Vasilis-Narain/Kibble/HARDWARE_SELECTION.md

## Hardware requirements

Target: 320x240, 16 bit colour, 60 fps. Mainly 2D games, possibly DOOM style 3D games.
Games are copied onto an SD card and loaded into internal SRAM at runtime.

### Overview
- MCU: STM32H7A3ZIT6Q (280MHz, 2MB flash, ~1.4MB sram, LQFP144)
- Display: [NHD-2.8-240320AF-CSXP-F](https://www.digikey.it/en/products/detail/newhaven-display-intl/NHD-2-8-240320AF-CSXP-F/9849907) (2.8" 240x320 IPS, ST7789Vi, 16-bit parallel 8080, TE pin)
- Audio: MAX98357AETE+T (I2S DAC + class-D amp) + 8 ohm 1W speaker
- Storage: microSD over SDMMC 4-bit
- Controls: 4 face + 4 D-pad + 2 shoulder + 2 menu + power button, hall effect joystick
- Power: 1S LiPo, USB-C charging, 3.3V for everything
- 1 green power LED

### MCU
- STM32H7A3 has 1MB of contiguous AXI sram - fits both framebuffers and a whole game, no external RAM needed
  - STM32H743 is faster (480MHz) but its RAM is split (largest block 512KB AXI) and it has no SMPS
- LQFP144 - exposes FMC pins, routes on 4 layers (BGA would need finer vias), JLCPCB-assembled
  - LCSC C730224 - check it's the -Q variant and in stock before ordering
- Q variant (internal SMPS) - same pinout as the NUCLEO-H7A3ZI-Q
  - 97 GPIOs in LQFP144 (non-Q: 112) - enough for the ~57 needed
  - SMPS roughly halves MCU current @280MHz (~34mA vs ~70mA with LDO, DS13195 table 37)
  - SMPS is optional - without its inductor + caps the chip runs from the internal LDO
- Double buffered framebuffer (2x 150KB) in internal AXI sram
- Game code + assets in the remaining ~700KB of AXI sram
- 8MHz HSE crystal - accurate clocks for USB and audio
- Decoupling + VCAP capacitors - follow the datasheet reference design

### Display
- [NHD-2.8-240320AF-CSXP-F](https://www.digikey.it/en/products/detail/newhaven-display-intl/NHD-2-8-240320AF-CSXP-F/9849907) ([datasheet](https://newhavendisplay.com/content/specs/NHD-2.8-240320AF-CSXP-F.pdf))
  - Bare panel, ST7789Vi controller built into the glass - no controller on the PCB
  - 40-pin 0.5mm FFC: Molex 54132-4062 socket on the PCB (LCSC C505102), JLCPCB-assembled
    - Bottom contact - FFC contacts must face the PCB, check against the panel's cable drawing
  - IM0, IM1, IM2 to GND = 16-bit 8080-II, DB0-DB15
  - VDD + VDDI to 3.3V
  - Panel is natively portrait (240x320) - rotate to landscape with MADCTL
- 16-bit parallel via FMC + DMA
  - 60 fps needs ~9.2MB/s (320 x 240 x 2 bytes x 60) - SPI can't reach this, parallel can
- TE pin to GPIO - start frame transfers on it to avoid tearing
- RESET pin to GPIO
- Backlight: bare LEDs (LED-A, LED-K1-K4), 3.1V, max 160mA
  - Needs a PWM-dimmable constant current driver
  - [ ] Pick backlight driver - 3.3V rail has too little headroom for 3.1V LEDs
- Current: 8mA logic + backlight (up to 160mA)

### Controls
- Face buttons + D-pad: conductive rubber pads over gold plated (ENIG) PCB pads
- Shoulder + menu buttons: tactile switches
- Joystick: hall effect, 2 ADC channels
- All buttons on GPIO with internal pull-ups
- Debounce in software (poll once per frame) - no circuit needed

### Audio
- MAX98357A shutdown pin to GPIO - avoids pops, saves power
- Volume control in software
- No headphone jack in v1

### Storage
- microSD socket with card detect: Hirose DM3AT-SF-PEJM5
- Card detect to GPIO
- 47k pull-ups on CMD, DAT0-3

### Power
- 1S LiPo, 1500mAh, with protection circuit, JST-PH 2.0 connector
- Charger with power-path: BQ24072RGTR - device runs while charging
- USB-C receptacle: GCT USB4105-GF-A - 5.1k pull-downs on CC1/CC2
- 3.3V buck-boost: TPS63020DSJR - works across full LiPo range (3.0-4.2V)
- Battery voltage: resistor divider to ADC
- Power button + green power LED (GPIO)
- [ ] Current budget (display backlight up to 160mA) after prototype measurements -> confirm regulator and battery size

### Debug / programming
- SWD: 2x5 1.27mm header (SWDIO, SWCLK, NRST, SWO)
- USB + BOOT0 button - flash over built-in DFU bootloader
- UART pins for logging - not PD8/PD9 (needed for FMC D13/D14)
- Reset button

### Pin budget
| Function | Peripheral | Pins |
|---|---|---|
| Display | FMC 8080 (16-bit) | 22 |
| Backlight | TIM PWM | 1 |
| SD card | SDMMC 4-bit + detect | 7 |
| Audio | I2S + shutdown | 4 |
| Buttons | GPIO | 13 |
| Power LED | GPIO | 1 |
| Joystick | ADC | 2 |
| Battery voltage | ADC | 1 |
| USB | OTG FS | 2 |
| Debug | SWD + UART | 4 |
| **Total** | | **57** |
