Vasilis-Narain/Kibble/(commit log)

2026-09-30 Squashed commit of the following:
    commit 84ba3b5c686c12c0cb50d7a0ae8ee7a0eafdb6f8
    Author: vasilis <vasilis.narain@hotmail.it>
    Date: Wed Sep 30 10:00:01 2026 +0200
    fix(vasilis): fix average return on 0-size array
    Fix the bug to see if unit-tests-action works properly
    commit e7fefd1a200c8a847f56e97b25ad93598703733e
    Author: vasilis <vasilis.narain@hotmail.it>
    Date: Wed Sep 30 09:47:56 2026 +0200
    feat(vasilis): add unit test framework to actions
    Unit tests are now ran in Docker, still using CppUTest.
    Called on push
    commit 4bbec6941edf54b008c7b89323024fd7cf5fc8df
    Author: vasilis <vasilis.narain@hotmail.it>
    Date: Wed Sep 30 09:33:00 2026 +0200
    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
2026-10-07 docs(vasilis): decision to use 8bit mode for prototype (#12)
    Documentation now reflects the decision to use 8bit parallel
    display mode for the prototype in order to avoid conflicts
    with the Nucleo's ST-LINK on PD8/PD9. Firmware should be mostly
    unchanged, performance metrics will be less trustworthy although
    they'd have been anyway due to using jumper wires.
2026-11-11 8 cubemx pin definitions (#14)
    * doc(vasilis): added DigiKey order list (.xlsx) for Prototype
    * feat(vasilis): added cubemx project dir + file
    * doc(vasilis): added DigiKey order list (.xlsx) for Prototype
    * feat(vasilis): added cubemx project dir + file
    * wip: cubemx project
    * wip
    * chore(vasilis): delete stale digikey order list
    * wip(vasilis): mpu and linker configured for FMC (display)
    Configured FMC pinout with temp timings (should be over recommended
    minimum settings) and also MPU regions + Linker script generation (MMT)
    defining RAM for double buffer + audio buffer.
    * wip(vasilis): display pins setup (added rst and te gpio)
    Also set FMC gpio Maximum Output speed for the prot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
2026-11-12 13 kicad schematic prototype 1 (#18)
    * added blank schematic file
    * feat(vasilis): added MCU side connections for FMC display
    Also edited .gitignore for KiCad files
2026-11-12 chore(vasilis): update includes to use new .c/.h driver setting on cubeMX
